wozlol/woz_gba_midi/schematics/SCH_GBAMIDI2_2026-07-11.pdf

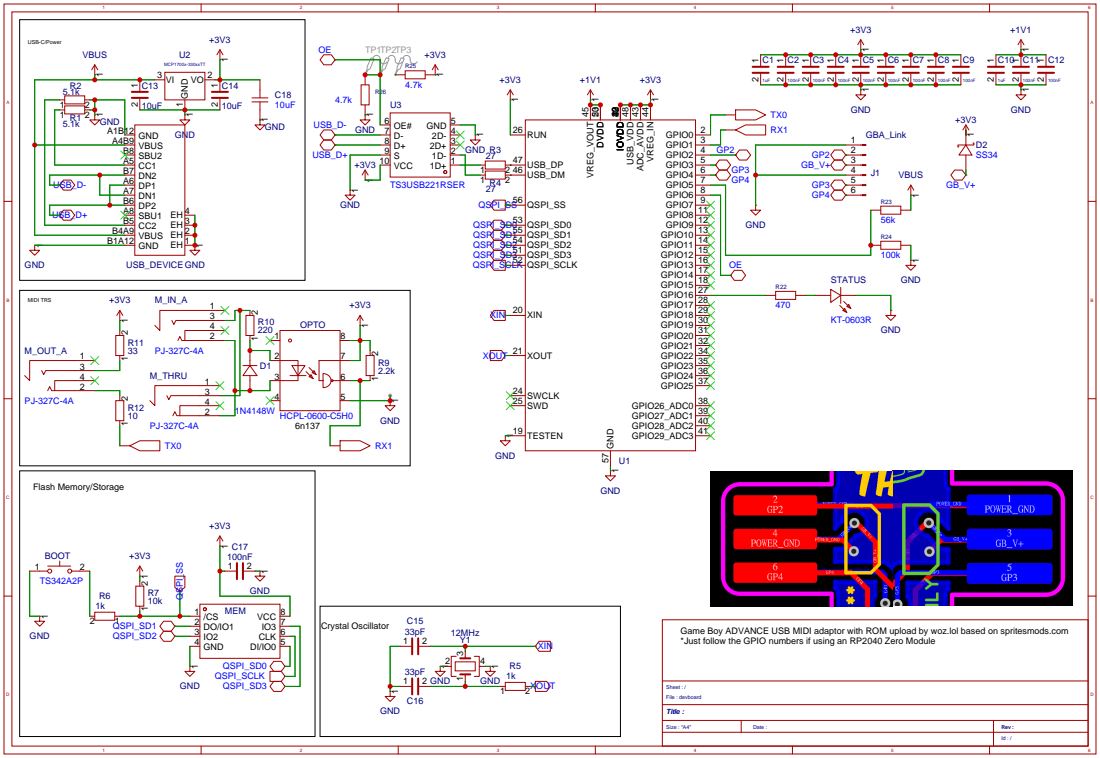
[picture p2: page 1]

Game Boy ADVANCE USB MIDI adaptor with ROM upload by woz.lol based on spritesmods.com
*Just follow the GPIO numbers if using an RP2040 Zero Module
